kaka12331/stm32f103-learning-board/BOM.md

# 主要器件清单

完整数量以嘉立创 EDA 导出的 BOM 为准。下表只列关键器件，便于采购和对原理图。

## 主控与时钟

| 位号 | 型号 | 封装/规格 | 立创编号 | 作用 |
| --- | --- | --- | --- | --- |
| U1 | STM32F103RCT6 | LQFP-64 | C8323 | Cortex-M3，72 MHz，256 KB Flash |
| X1 | X32258MOB4SI | 3225，8 MHz，12 pF | C2682775 | HSE |
| X2 | XKXGI-SUA-32.768K | 3215，32.768 kHz | C5213671 | LSE / RTC |
| C17–C20 | 18 pF ±5% 50 V | 0603 | C1647 | 晶振负载电容 |
| BT1 | CR1220-2ZX | CR1220 座 | C969906 | RTC 后备电池 |
| D1 | BAT54C | SOT-23 | C9900013520 | VBAT 隔离 |

## 电源与 Type-C

| 位号 | 型号 | 说明 | 立创编号 |
| --- | --- | --- | --- |
| USB1 | TYPE-C 16PIN 2MD(073) | 供电口，卧贴 16P | C2765186 |
| USB2 | TYPE-C 16PIN 2MD(073) | UART / 自动下载口 | C2765186 |
| U2 / U3 / U9 | CH213K | Type-C CC 识别，向充电器要 5 V | C5456874 |
| U4 | AMS1117-3.3 | 5 V → 3.3 V，1 A LDO | C6186 |
| R1–R4 | 5.1 kΩ | CC 下拉 | C23186 |

## USB 转串口与下载

| 位号 | 型号 | 说明 | 立创编号 |
| --- | --- | --- | --- |
| U15 | CH340C | USB 转 UART，配合自动下载 | C84681 |
| Q2 | S8550 | PNP，复位控制 | C2931720 |
| Q3 | S8050 | NPN，BOOT / 复位辅助 | C2931719 |

## 人机接口

| 位号 | 型号 | 说明 | 立创编号 |
| --- | --- | --- | --- |
| TFT1 | 1.8 TFT 128×RGB×160 | SPI 彩屏 | C9900080251 |
| BUZZER1 | MLT-5020 | 无源电磁蜂鸣器 4 kHz | C94598 |
| Q1 | SS8050 | 蜂鸣器驱动 NPN | C431710 |
| SW2 | TS-1101-C-W | 复位键 | C318938 |
| SW1 / SW3 | 6×6 轻触 | 用户按键 | — |
| VR1 | 3362P-1-103LF | 10 kΩ 电位器，ADC 练习 | C58159 |
| LED1 | NCD0603R1 | 红灯 | C84263 |
| LED2 / LED3 | NCD0603C1 | 绿灯 | C84264 |

## 连接器（部分）

| 类型 | 典型型号 | 立创编号 | 用途 |
| --- | --- | --- | --- |
| 2.54 1×20 直针 | C50981 | C50981 | GPIO 排针 |
| 2.54 1×14 | PZ254-1-14-Z-8.5 | C2894937 | 扩展 |
| 2.54 1×8 | PM254-1-08-Z-8.5 | C2897371 | 扩展 |
| 2.54 1×6 | C37208 | C37208 | 扩展 |
| 2.54 2×3 | HDR-M_2.54_2x3 | C402781 | BOOT / 跳线 |
| XH2.54 4P | 多处 | C9900018341 等 | 外设线序接口 |
| XH2.54 6P | XH2.54mm-LI-6P | C2842318 | I2C / SPI 等 |
| 2P 电源座 | WAFER-XH254 / HX 2.54-2P | — | +5 V 接口 |

电阻电容以 0603 为主。电源去耦 100 nF 若干；二极管还有 1N5819WS（D2）、1N4007W（U16）。
