kaka12331/stm32f103-learning-board/(list of files, drawings)

Other design files:
hardware/ProPrj_STM32学习板_2026-09-11.epro
hardware/stm32rct6开发板.epro
