kaka12331/stm32f103-learning-board/(commit log)

2026-09-11 Initial commit: STM32F103RCT6 learning board (EasyEDA Pro)
    Add the 2026-09-11 .epro, BOM, and a Chinese README covering
    power/UART Type-C, CH340 auto-download, 1.8 inch SPI LCD, and fab notes.
    [ProPrj_STM32学习板_2026-09-11.epro]
2026-10-22 Add 2026-10-22 STM32RCT6 EasyEDA project
    Upload stm32rct6开发板.epro (project title 教学) beside the
    2026-09-11 learning-board export.
    [stm32rct6开发板.epro]
